jakplugg/utidesII/readme.md

# uTides II; 

### 8hp version of Tides II.

#### PCB redesign by J. Matheson. it works with the same firmware, 

[PRELIM BOM](https://docs.google.com/spreadsheets/d/1-noEUNMvQ01j1G_RPvI6Sw2XINWkwmGn7XqkqtemxPE/edit?usp=sharing)

8 hp 0603 version of tides II. the only change "both ways" power as usual.
