jakplugg/utidesII/(list of files, drawings)

Other design files:
PCBPanel/uTides_PCBpanel.dip
uTidesII.dch
uTidesII.dip
