jakplugg/utidesII/(threads)

Thread 1 (2019-11-12):

R56, R57, R58, R59, R60  Pots

alxsakh, 2019-11-12:
Hi Jak! pots R56, R57, R58, R59, R60 must be Clear-Shaft? can you give link for them?

jakplugg, 2019-11-12:
Only if you want to use the LED pot option. they are these. https://www.mouser.ca/ProductDetail/ALPS/RK09K1130D62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

Thread 4 (2020-10-05):

uTides2 Led orientation

sonic2ndtwelve, 2020-10-05:
Hi Jak, Can you let me know what the orientation is for the potentiometer LED's, D13-D22? Is the dot on the PCB for anode or cathode?

Also, can you tell me the orientation for LED 4-7 as well - is the leg marked with a square, positive or negative.

Thanks.

robsanderson69, 2020-11-04:
For LED's D13-D22 the cathode of the LED goes to the dot on the PCB. My LEDs had a 'T' marked on the base to indicate the orientation-
https://www.mouser.co.uk/datasheet/2/445/150060VS55040-1715060.pdf
To be sure I checked the orientation by powering up the uTides before I installed the pots over the LEDs.

I haven't installed LEDs 4-7 yet but I do know that they're bi-colour, so orientation dictates their colour, i.e. red or green depending which way the current flows.
My plan for these LEDs, along with LEDs 1-3, was to flash the firmware to the module, then insert one of each LED to check their orientation.

sonic2ndtwelve, 2020-11-04:
Hi, Thanks. I managed to also work out that the dot indicated the cathode. 4-7 should be installed as per the photo on the Pusherman website. Mine all works ok and the DAC calibration, although complicated, works fine. Be aware that I got a short from the back of the power header to the casing of the potentiometer that is positioned next to it. I solved it by gently bending the pot casing inwards a bit. Other than that, the module works a treat.

robsanderson69, 2020-11-07:
Doh! I didn't notice that the casing of one of the pots was touching the +12V input. Now when I power the module I've got a mystery short. Although I've successfully flashed the STM32 the buttons don't seem to work. Could be that I've fried it as I can't figure out where else to the short could be?

sonic2ndtwelve, 2020-11-09:
Hey There. I would suggest erasing the MCU and re-flashing it. My module acted strange after I flashed it with the short but once the short was fixed I was able to re-flash it OK. Once flashed, it should go straight in to calibration mode, where the LED's go crazy. Mine now works fine.
